tayebzaidi/HueWheel/docs/renders/counterbore.png

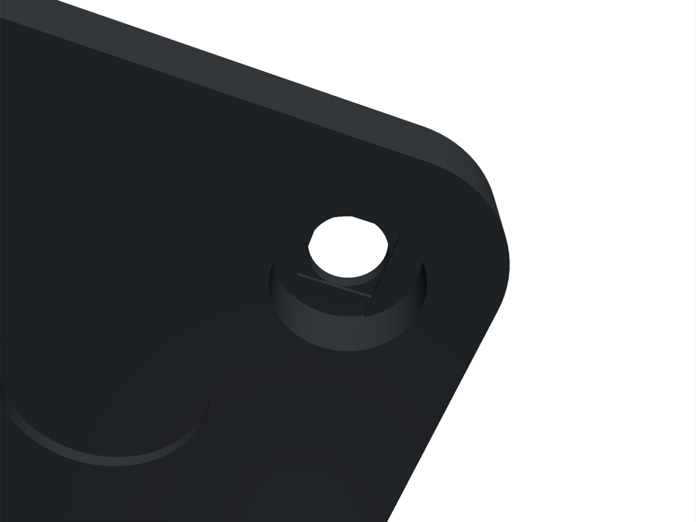
docs/renders/counterbore.png
