tayebzaidi/HueWheel/docs/renders/encoder_cradle.png

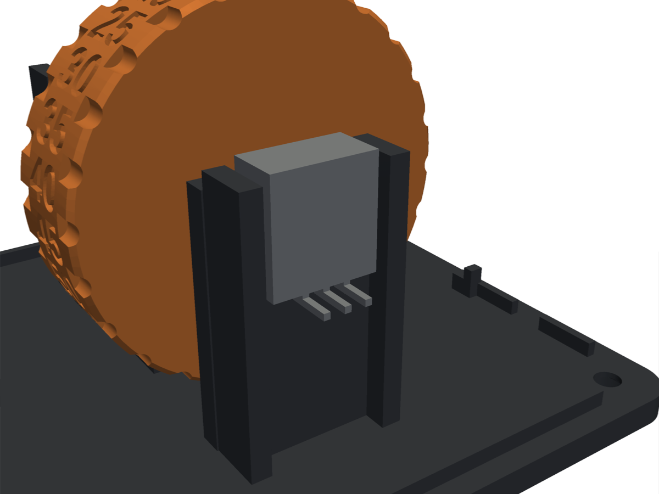
docs/renders/encoder_cradle.png
