tayebzaidi/HueWheel/docs/renders/eye_level_10deg.png

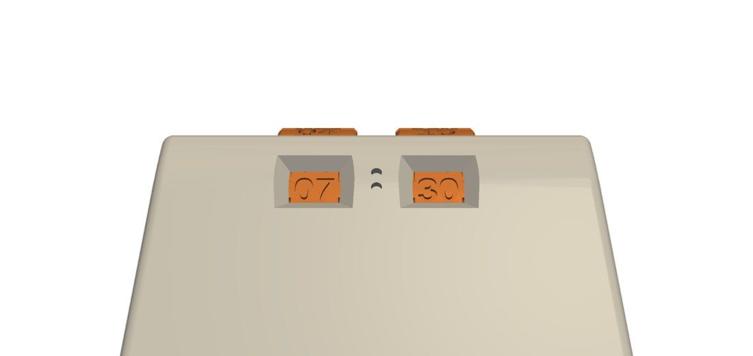
docs/renders/eye_level_10deg.png
