tayebzaidi/HueWheel/docs/renders/eye_level_25deg.png

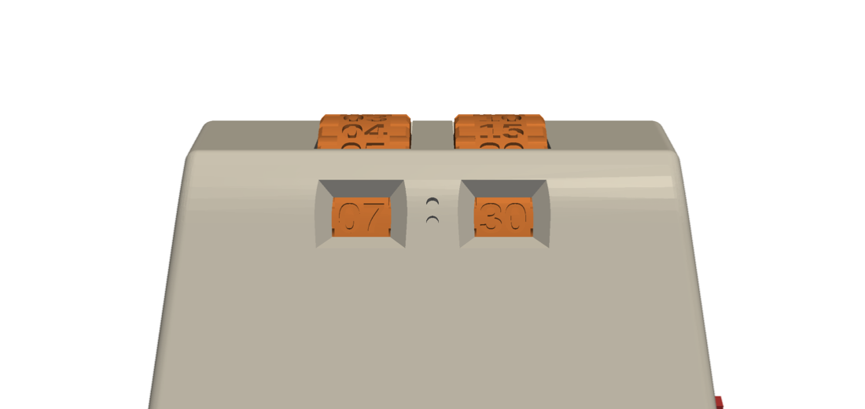
docs/renders/eye_level_25deg.png
