tayebzaidi/HueWheel/docs/renders/eye_level_46deg.png

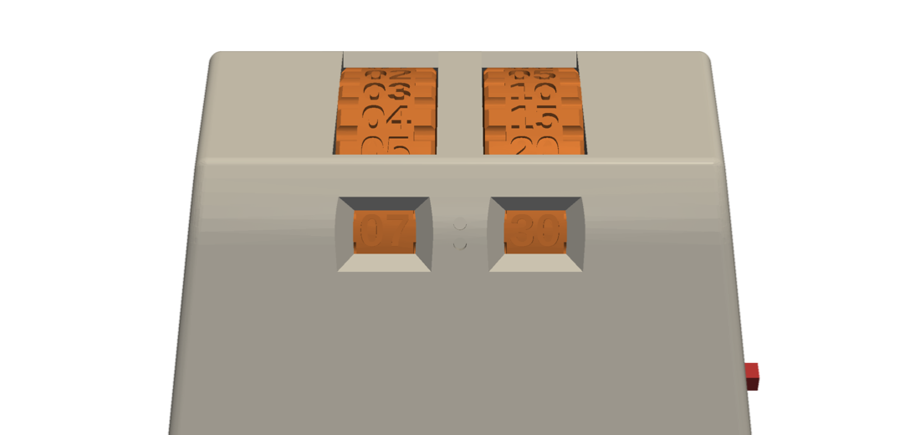
docs/renders/eye_level_46deg.png
