tayebzaidi/HueWheel/docs/renders/internals.png

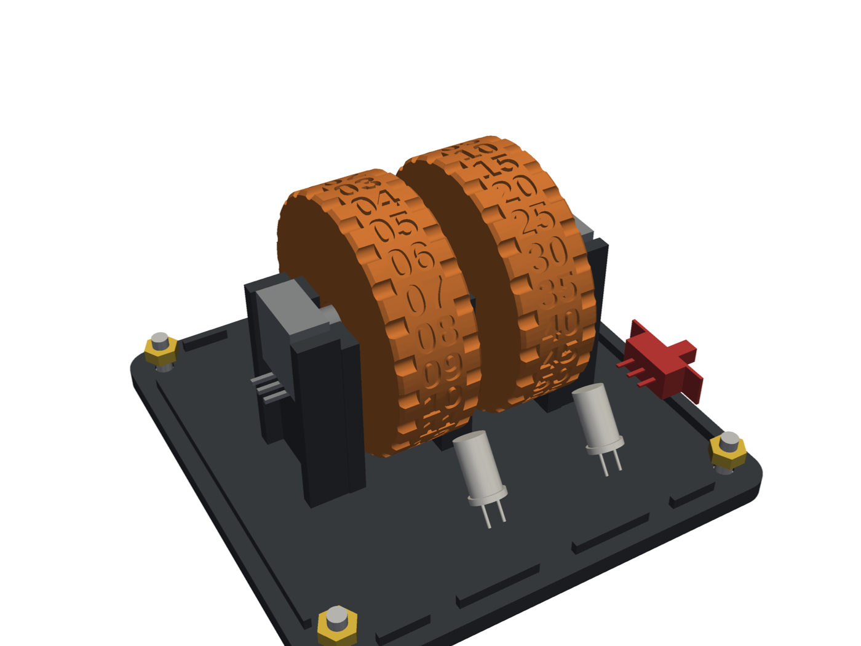
docs/renders/internals.png
