tayebzaidi/HueWheel/docs/renders/led_insert.png

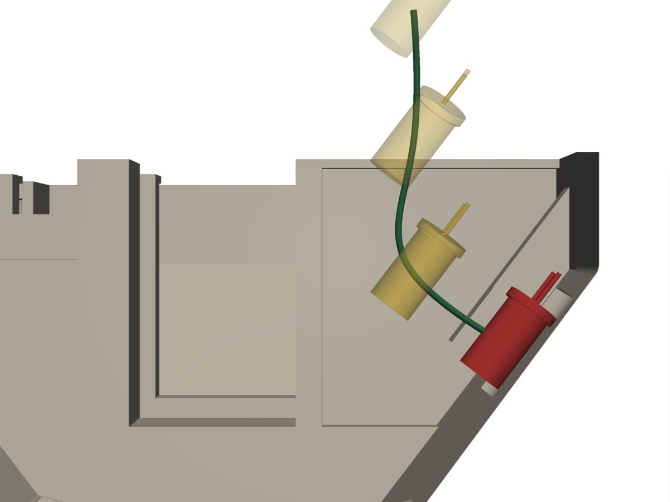
docs/renders/led_insert.png
