tayebzaidi/HueWheel/docs/renders/mcu_bay.png

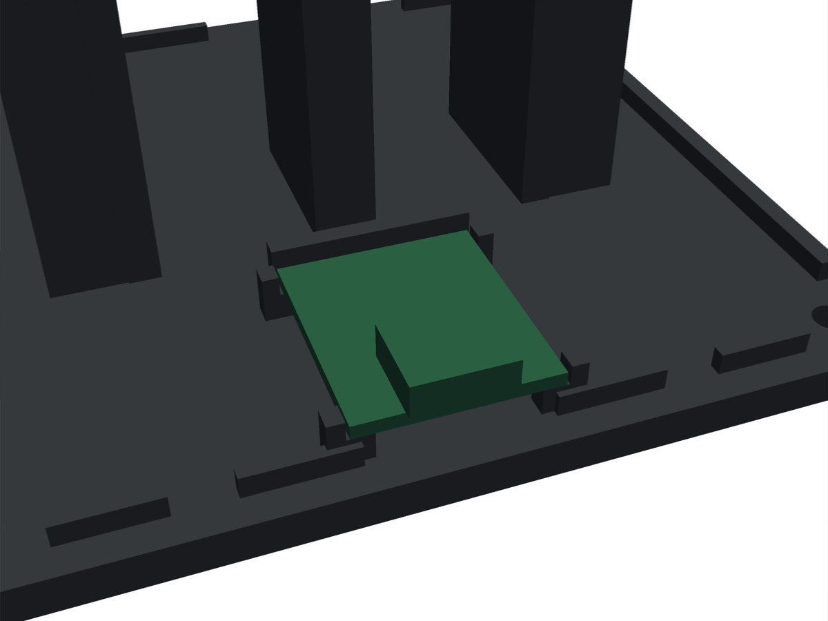
docs/renders/mcu_bay.png
