tayebzaidi/HueWheel/docs/renders/nut_slot.png

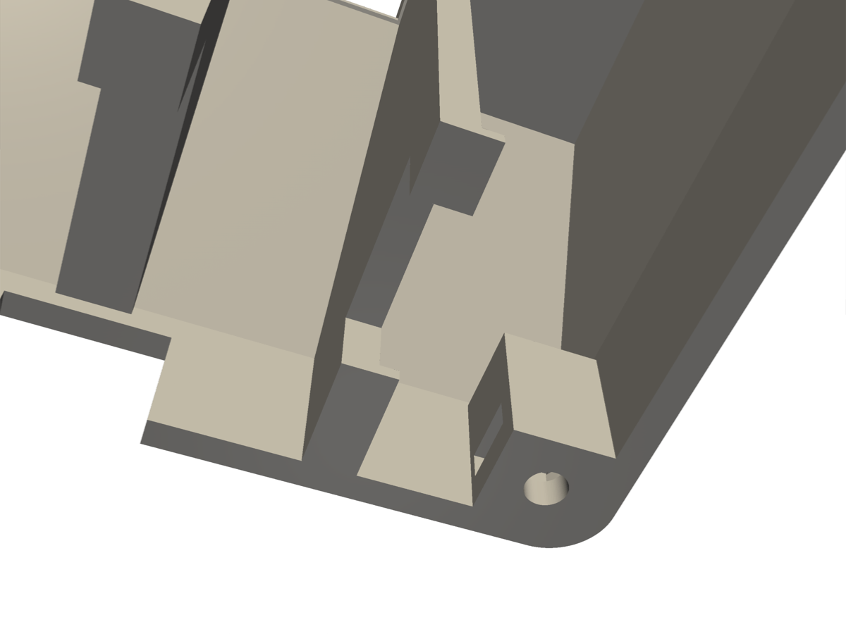
docs/renders/nut_slot.png
