tayebzaidi/HueWheel/docs/renders/plate_lip.png

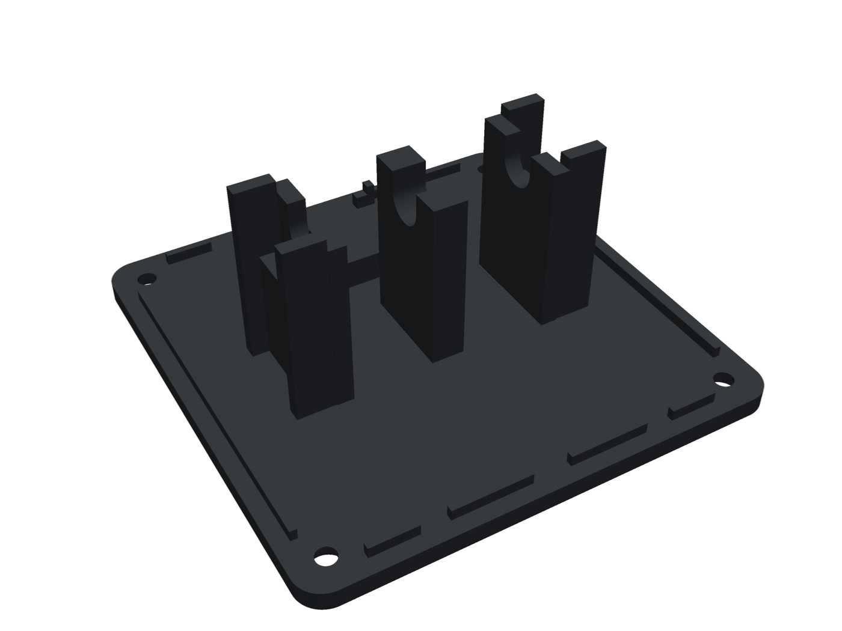
docs/renders/plate_lip.png
