tayebzaidi/HueWheel/docs/renders/section_led.png

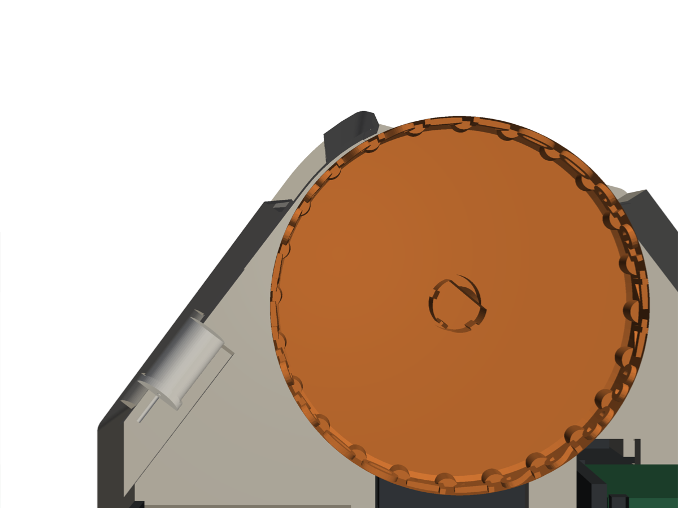
docs/renders/section_led.png
