tayebzaidi/HueWheel/docs/renders/section_nut.png

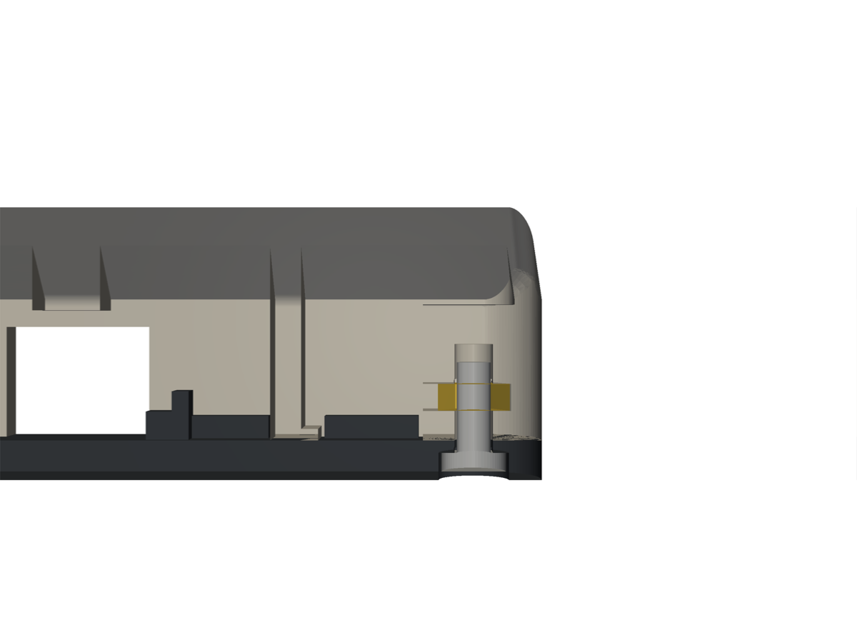
docs/renders/section_nut.png
