tayebzaidi/HueWheel/docs/renders/section_switch.png

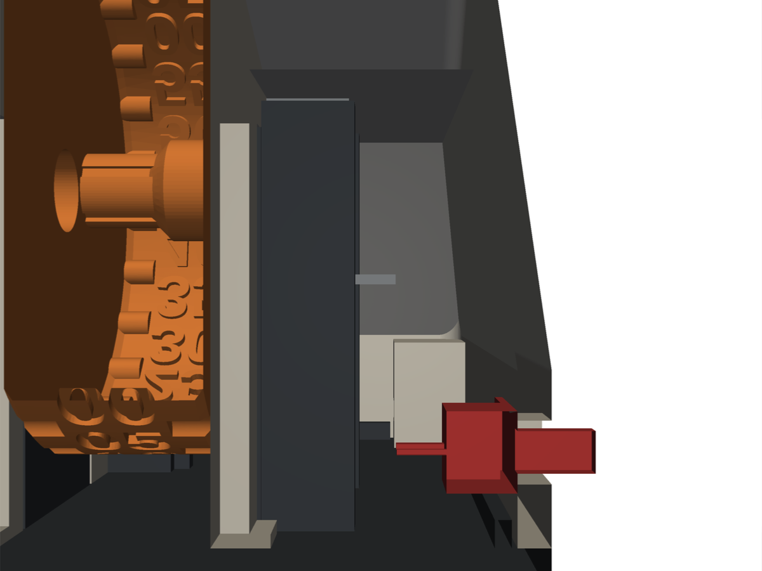
docs/renders/section_switch.png
