tayebzaidi/HueWheel/docs/renders/section_x0_usb.png

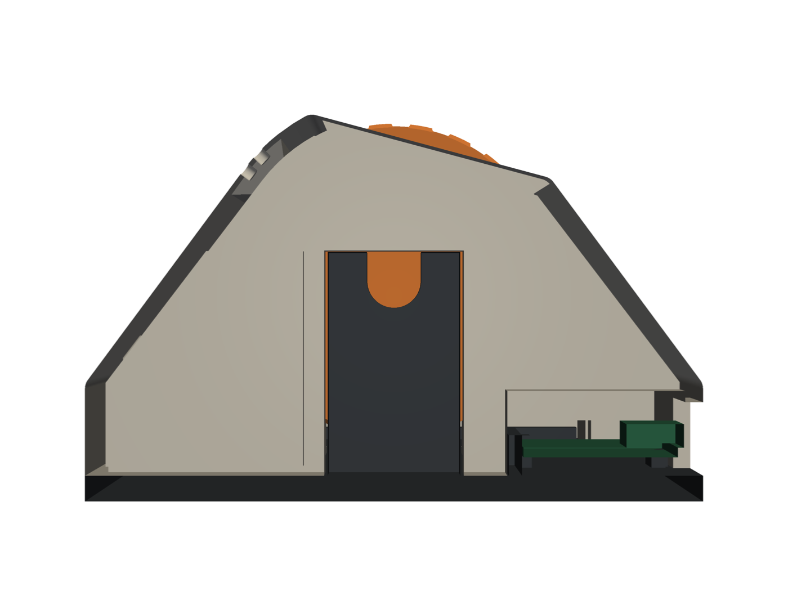
docs/renders/section_x0_usb.png
