tayebzaidi/HueWheel/docs/renders/section_x19_caps.png

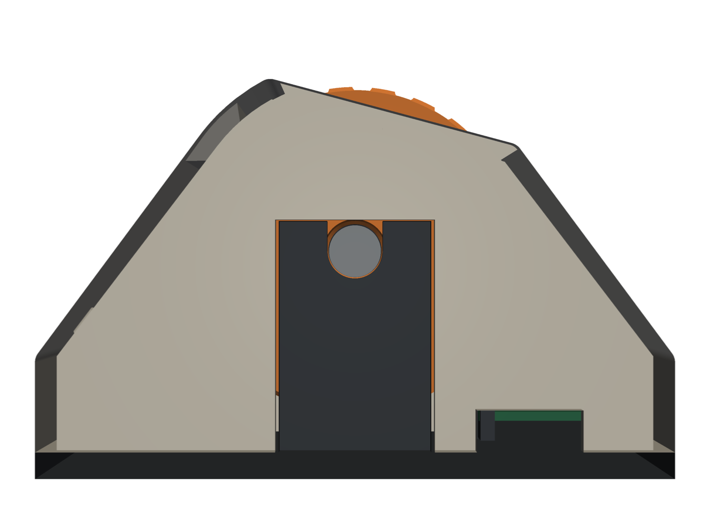
docs/renders/section_x19_caps.png
