tayebzaidi/HueWheel/docs/renders/section_x24_encoder_cap.png

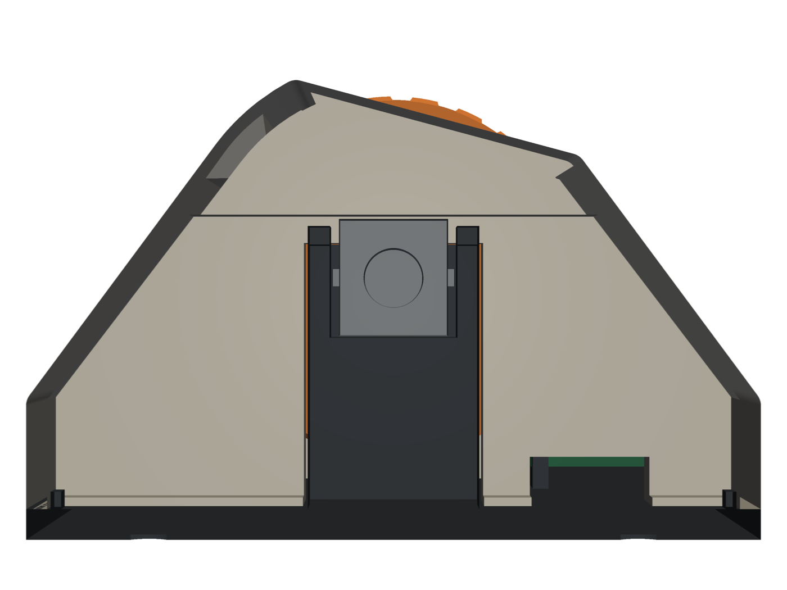
docs/renders/section_x24_encoder_cap.png
