tayebzaidi/HueWheel/docs/renders/section_y0.png

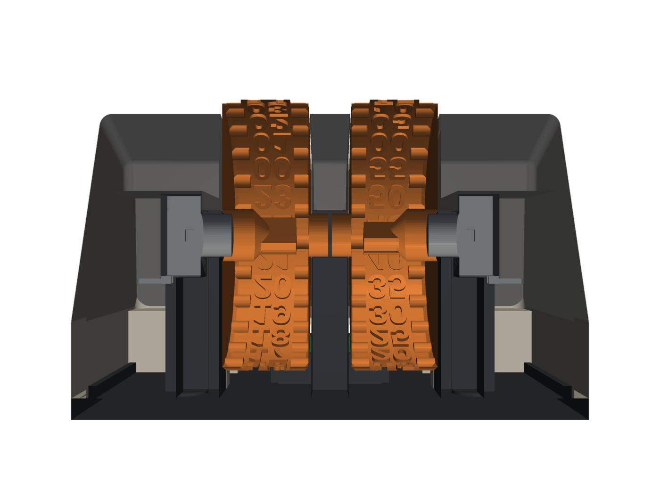
docs/renders/section_y0.png
