tayebzaidi/HueWheel/docs/renders/shell_inside.png

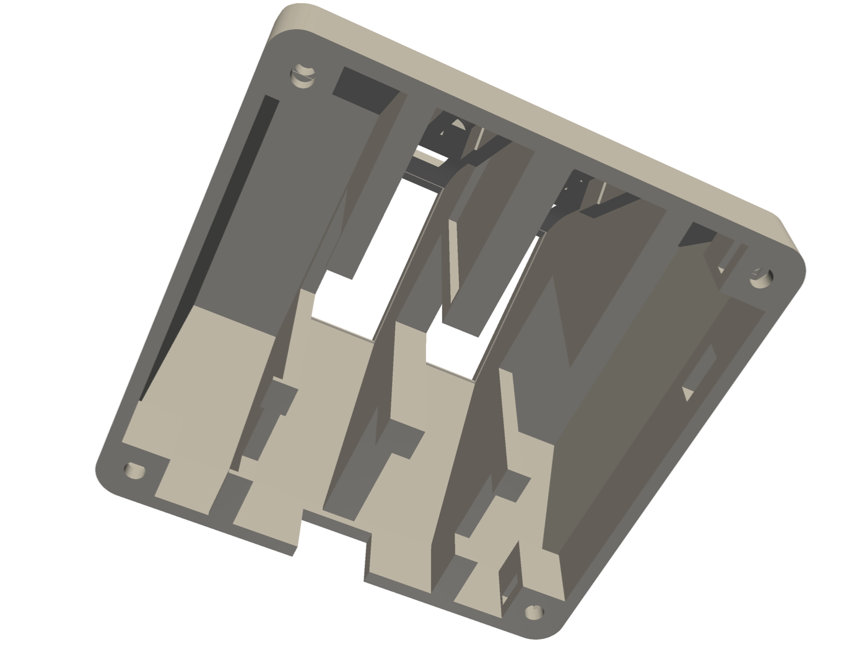
docs/renders/shell_inside.png
