tayebzaidi/HueWheel/docs/renders/underside.png

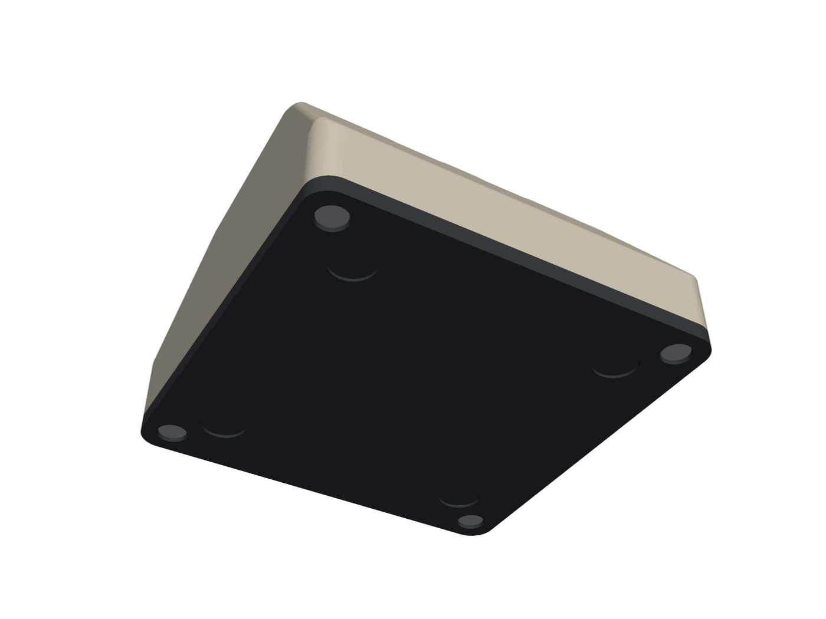
docs/renders/underside.png
