tayebzaidi/HueWheel/docs/renders/window_closeup.png

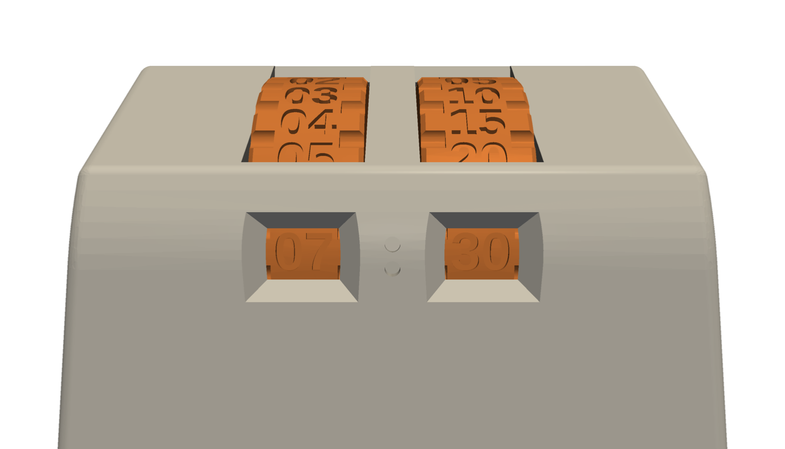
docs/renders/window_closeup.png
