tayebzaidi/HueWheel/bom/HueWheel_BOM.xlsx

Sheet: BOM
HueWheel Bill of Materials
How to use: edit the yellow cells only. Have? = Y if you already own it. Include? = N to leave an item out. Unit prices are planning estimates, not quotes; update them when you order.
Item | Specification | Qty | Unit price ($) | Have? | Include? | Line cost if buying everything ($) | Still to buy ($) | Price basis | Notes
Philips Hue Bridge | Your existing bridge | 1 | $0.00 | Y | Y |  |  | Already owned | Must be reachable from 2.4 GHz Wi-Fi. EXAMPLE ROW: shows a filled-in Have?.
Rotary encoder, 24-detent | Bourns PEC11R-4215F-N0024: 24 detents, 24 pulses, 15 mm flatted shaft, rear-facing pins, no push switch. PEC11R-4215F-S0024 (with push switch) also fits. | 2 | $2.95 |  | Y |  |  | S0024 at DigiKey, from a mymectronic aggregator snapshot; N0024 price not checked. Confirm at checkout | Do NOT substitute a different detent count: the wheel numbering depends on 24. Dimensions checked against the Bourns datasheet (rev 04/26).
Seeed XIAO ESP32C3 | DigiKey 113991054: Wi-Fi microcontroller, 21 x 17.8 mm, USB-C, antenna included | 1 | $5.00 |  | Y |  |  | Estimate from regional DigiKey listings (EUR 4.27 ex VAT, JPY 794). Check stock and lead time for the US | Chosen so everything comes from one vendor. Not the version with pre-soldered headers (102010633). The owned Pis are too big, and the micro:bits and Artemis have no Wi-Fi.
Slide switch (alarm on/off) | E-Switch EG1201A (DigiKey EG1902-ND): SPDT, panel mount, 5.5 mm actuator, 3 mm travel | 1 | $0.80 |  | Y |  |  | Estimate. Regional DigiKey EUR 0.72 at qty 1; TME USD 0.78. Confirm at checkout | Fits the existing 9 x 4.5 mm side slot and clears the 2.4 mm wall. Avoid the EG1201 and EG1218: their actuators are too short. Hot-glued from inside.
Shipping | Single DigiKey order | 1 | $7.00 |  | Y |  |  | Estimate, not checked. Confirm at checkout | Set Have? to Y if your order ships free.
5 V 1 A USB-A wall adapter | Phihong PSAA05A-050QL6-R (DigiKey 993-1394-ND): 5 V, 1 A, US plug | 1 | $4.00 |  | N |  |  | Estimate from DigiKey Australia AUD 6.14 at qty 1; US price not checked. Confirm at checkout | On hold, left out of the total. Any USB-A phone charger works.
USB-A to USB-C cable | Edatec ED-CAB-USBC: USB 2.0, 1 m. StarTech USB2AC1M is an alternative | 1 | $2.00 |  | N |  |  | DigiKey US listing, USD 2.00 at qty 1 (search snapshot). Confirm stock at checkout | On hold, left out of the total. A-to-C avoids any question of USB-C charger negotiation. Must carry data as well as power, so it can also flash the firmware.
Hookup wire | 26-30 AWG, about 1 m total | 1 | $2.00 | Y | Y |  |  | Already owned
M3 x 8 button head screws + M3 nuts (4 of each) | From the Mywish 1290-piece M2-M5 304 stainless button head kit. Nuts slide into slots in the shell's corner blocks | 1 | $17.99 | Y | Y |  |  | Amazon listing price, received | Whole kit cost shown; counted as shop stock, so not in Still to buy. Use the 8 mm screws: 12 mm and longer bottom out before the head seats.
PLA filament | About 120 g total, see Printed Parts tab | 120 | $0.02 | Y | Y |  |  | Already owned | Bambu X1 Carbon. Colours to be decided later.
Hot glue | Slide switch mount, and four dots as feet | 1 | $0.00 | Y | Y |  |  | Already owned | Replaces rubber feet.
Ballast | Steel washers, nuts or coins glued inside the front of the base | 1 | $0.00 |  | N |  |  | Scrap | Only if it slides when you roll a wheel.
Numeral contrast | Fine marker or paint pen in the engraved numerals | 1 | $0.00 | Y | Y |  |  | Already owned | Use black or another dark colour: a red numeral disappears under a red LED.
LEDs (window light) | 5 mm through-hole, diffused if available; red or amber recommended. 3 mm also works: set LED_D and LED_LEN in cad/huewheel.py | 2 | $0.05 | Y | Y |  |  | Already owned | One per window, in holders inside the front slope.
Resistors for the LEDs | 220-470 ohm, 1/4 W through-hole, one per LED, from your kit | 2 | $0.02 | Y | Y |  |  | Already owned | Solder in line with each LED, then cover with tape or heat shrink.
 | If you bought every included item
 | Still to buy
 | Budget |  |  |  |  |  | $30.00
 | Left in budget

Sheet: Printed Parts
Printed Parts
Weight and time: PrusaSlicer 2.9.6 default 0.4 mm profile, 0.2 mm layers, 15% infill, PLA at 1.24 g/cm3. Your printer's times will differ.
Part | STL | Qty | Weight (g) | Time (h) | Supports | Print orientation
Base plate | cad/stl/plate.stl | 1 | 27.9 | 2.97 | None | Flat as exported; cradles point up
Shell | cad/stl/shell.stl | 1 | 71.5 | 5.42 | Build plate only (figures include them) | Open side down on the bed, as exported
Hours wheel | cad/stl/wheel_hours.stl | 1 | 9.3 | 0.82 | None | On its side, stub boss up, as exported
Minutes wheel | cad/stl/wheel_minutes.stl | 1 | 9.4 | 0.83 | None | On its side, stub boss up, as exported
Total
