tayebzaidi/HueWheel/cad/stl/wheel_minutes.stl

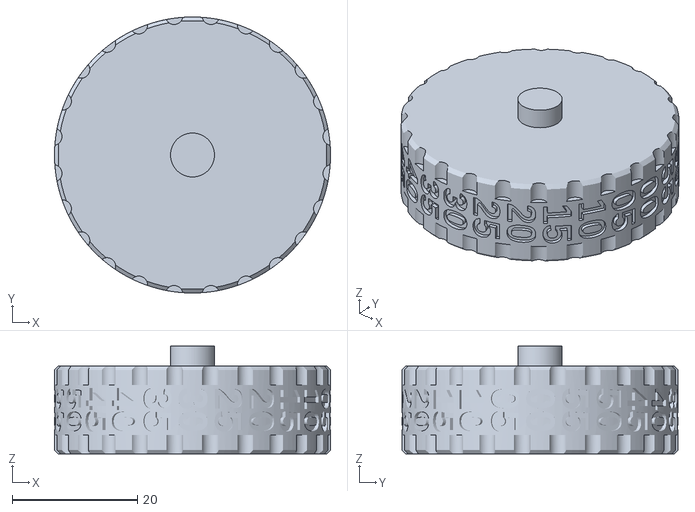
[picture p24: CAD file, 2026-11-09]
cad/stl/wheel_minutes.stl
44.0 x 44.0 x 17.2
