tayebzaidi/HueWheel/cad/test/rib_test.stl

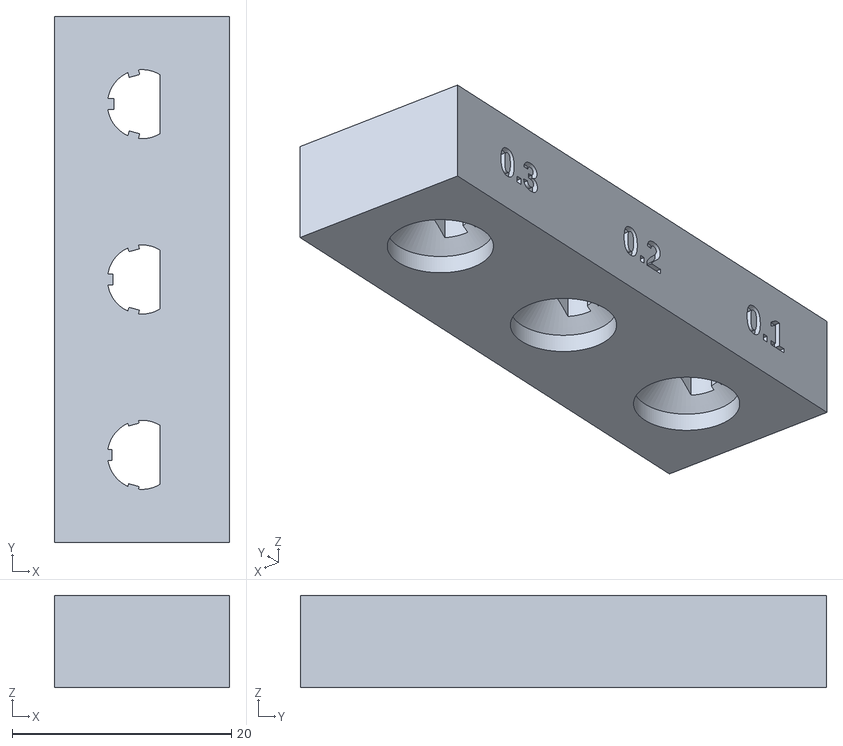
[picture p25: CAD file, 2026-11-09]
cad/test/rib_test.stl
16.0 x 48.0 x 8.40
