tayebzaidi/HueWheel/cad/stl/shell.stl

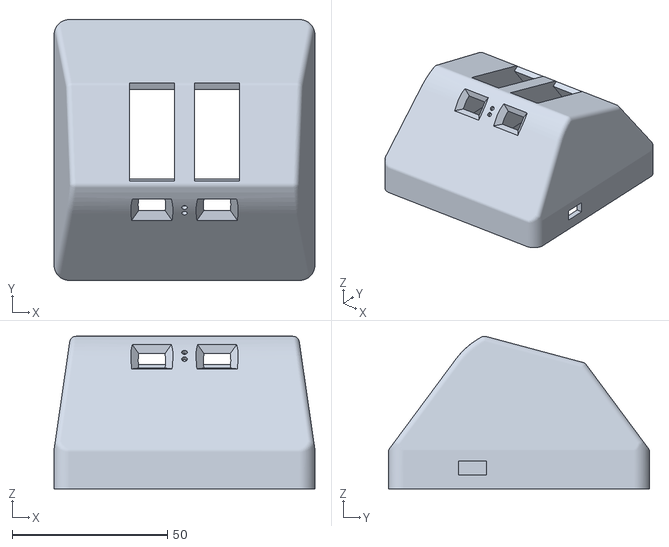
[picture p26: CAD file, 2026-11-06]
cad/stl/shell.stl
84.0 x 84.0 x 49.1
