tayebzaidi/HueWheel/cad/test/clamp_test.stl

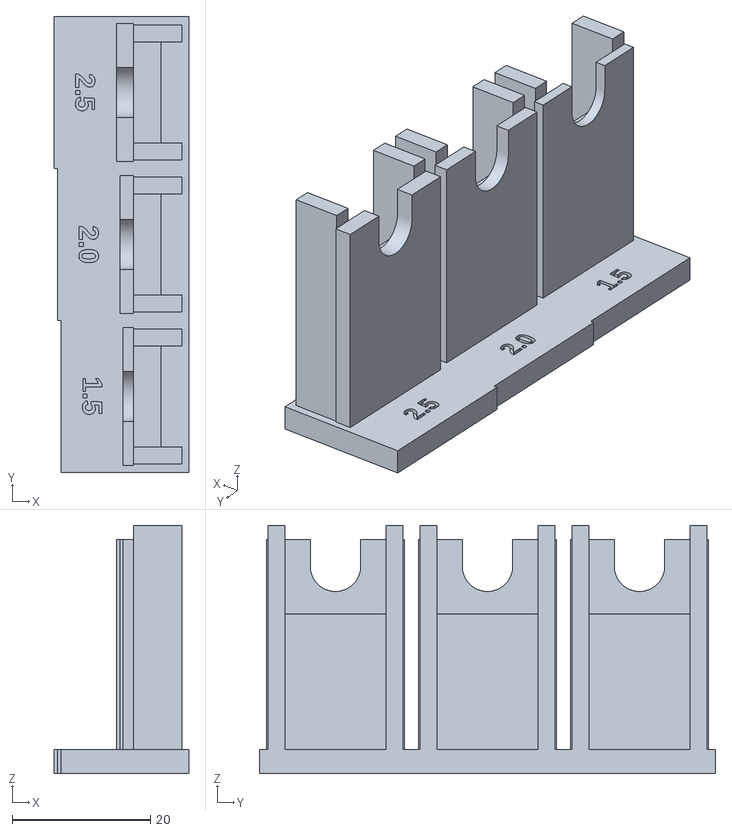
[picture p27: CAD file, 2026-11-09]
cad/test/clamp_test.stl
19.5 x 66.0 x 35.9
