tayebzaidi/HueWheel/cad/stl/plate.stl

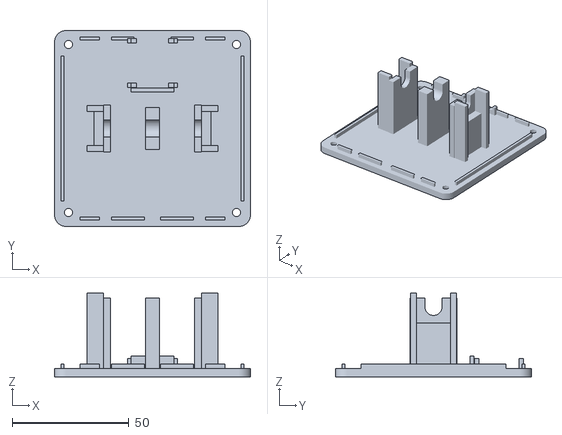
[picture p28: CAD file, 2026-11-04]
cad/stl/plate.stl
84.0 x 84.0 x 35.9
