tayebzaidi/HueWheel/cad/test/nut_test.stl

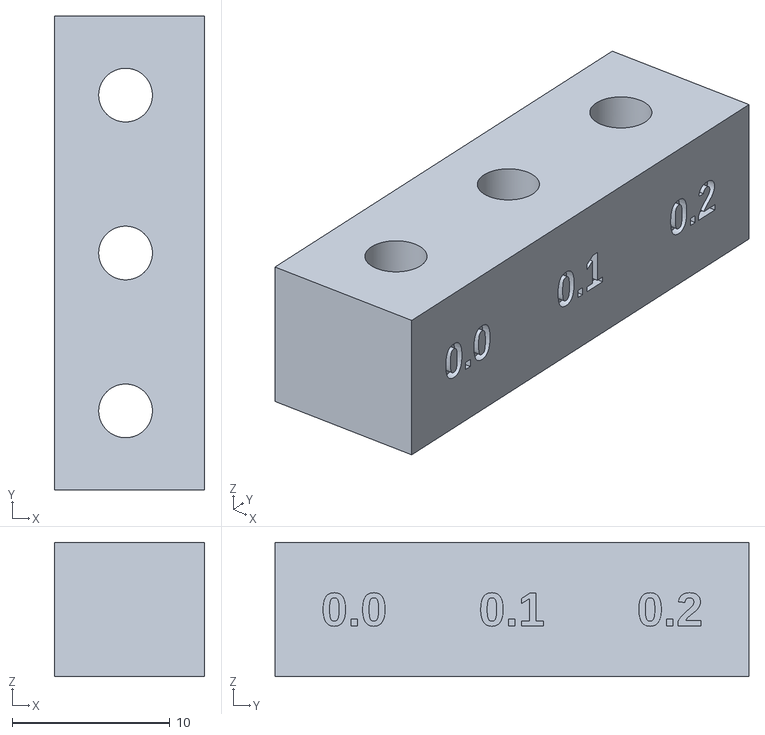
[picture p29: CAD file, 2026-11-09]
cad/test/nut_test.stl
9.50 x 30.0 x 8.50
