tayebzaidi/HueWheel/(list of files, cad)

Other CAD files:
cad/stl/wheel_hours.stl
