tayebzaidi/HueWheel/(commit log)

2026-11-02 Add first-pass HueWheel enclosure CAD, BOM and README
    [HueWheel_BOM.xlsx, plate.stl, shell.stl, wheel_hours.stl, wheel_minutes.stl]
2026-11-02 Match encoder geometry to Bourns datasheet and update BOM for owned hardware
    Correct the shaft flat, bushing, body and pin clearances, move the board
    mount to the XIAO ESP32C3, and consolidate purchases into one vendor.
    [HueWheel_BOM.xlsx, plate.stl, shell.stl, wheel_hours.stl, wheel_minutes.stl]
2026-11-02 Specify the E-Switch EG1201A alarm switch in the BOM
    [HueWheel_BOM.xlsx]
2026-11-02 Specify DigiKey M3 screws and deepen plate counterbores
    [HueWheel_BOM.xlsx, plate.stl]
2026-11-02 Record the ordered M3 screw kit in the BOM
    [HueWheel_BOM.xlsx]
2026-11-02 Specify DigiKey USB adapter and cable in the BOM
    [HueWheel_BOM.xlsx]
2026-11-02 Put USB adapter and cable on hold in the BOM
    [HueWheel_BOM.xlsx]
2026-11-02 Fit the model to the final parts and add assembly checks
    Replace the board rails with corner seats that leave the soldered edges
    clear, model the slide switch and M3 button head screws, enlarge the
    USB cable notch, and test the assembly paths and switch travel.
    [HueWheel_BOM.xlsx, plate.stl, shell.stl]
2026-11-02 Replace plastic screw threads with captive M3 nuts
    Add a side-loading nut slot to each shell corner block, clear the screw
    bores, and check nut insertion and screw engagement.
    [HueWheel_BOM.xlsx, shell.stl]
2026-11-02 Improve numeral visibility and add LED window lighting
    Flare the windows, enlarge the digits, lower the window for shallow
    viewing angles, and add two LED holders using parts already on hand.
    [HueWheel_BOM.xlsx, shell.stl, wheel_hours.stl, wheel_minutes.stl]
2026-11-02 Add first-draft firmware and Hue dry-run tool
    Firmware for the XIAO ESP32C3: reads both encoders and the alarm switch,
    saves the wheel position, and sends the time to a Wake Up automation once
    the wheels go quiet. Includes a re-sync gesture and a pin map.
    tools/hue_dryrun.py makes the same edit from a PC. Tested that way against a
    real bridge; the firmware itself has not run on hardware yet.
2026-11-03 Make all parts print without supports; add 3D viewer
    The first shell print failed where it hung over air: the tilted roof
    over the encoders, the retaining ribs and the LED holders. The plate's
    counterbores failed too.
    - Shell: the encoder roof and retaining ribs become solid blocks with
    flat undersides that bridge wall to wall. Pillars from the bed keep
    each bridge to 21 mm or less. The plate's U-cradles are 3 mm lower so
    the shell caps them.
    - LED holders sit on two fins from the bed, joined by a short bridge.
    - Screw holes in the plate and nut slots: two bridged layers (a slot,
    then a square) before the round hole.
    - Wheels: 45 degree cone at the bottom of the shaft pocket.
    - cad/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
    [plate.stl, shell.stl, wheel_hours.stl, wheel_minutes.stl]
2026-11-03 Document the single conda environment for the CAD tools
    All CAD scripts, the print check, renders and viewer now run in one
    conda environment. The README explains how to make Anaconda's VTK open
    windows on Linux: use the system Mesa, and preload the system's newer
    libstdc++ and libdrm. printcheck.py also needs rtree.
2026-11-03 Shell: replace free-standing pillars with walls tied to the outer shell
    The second shell print failed: the six 31 mm support pillars under the
    retainer caps stood alone on 3 mm footprints and fell over. Each retainer
    is now a wall from the bed out to the front and rear walls, with a window
    over its cradle. The centre rear wall arches over the board and USB-C
    port, and the rear encoder walls have a doorway for the encoder and
    switch wires. LED fins go from 1.2 to 1.6 mm.
    printcheck.py now also fails narrow islands growing from the bed that
    stand taller than 5x their width before joining a wide part; it flags
    exactly the six pillars that fell. README gains full print settings.
    Co-Authored-By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
    [shell.stl]
2026-11-03 Shell: thicken thin inner walls and give them bed feet
    On the third shell print a 1.6 mm LED fin curled up off the bed on the
    first layer. The fins go from 1.6 to 2.4 mm, growing outward so the lead
    gap is unchanged, and the front centre rib from 2.0 to 3.0 mm. The first
    1 mm of each thin wall is now 1.5 mm wider per side: each fin pair stands
    on one pad, and the encoder walls flare outward only so the shell still
    drops on past the wheels. Fit check and print check pass.
    printcheck.py now fails first-layer strips narrower than 2.4 mm (the outer
    wall); it flags exactly the old fins and rib.
    [shell.stl]
2026-11-04 Heat-set inserts, plate lip and open LED slots
    - Shell corner blocks take M3 x 6 x 4.2 heat-set inserts instead of captive
    nuts, which were hard to place and too tight. Each hole opens on the shell
    underside with a lead-in chamfer and a 45 degree cone roof.
    - New insert test block in cad/test/ to pick the hole size (3.8-4.2 mm)
    before printing the shell.
    - Plate gets a low lip just inside the shell wall to seat the shell before
    the screws go in. It steps around every shell wall and foot at the edge.
    - LEDs default to 5 mm and sit 8 mm lower on the front slope, clear of the
    wheels. The closed tube holder could not be fitted with an LED, so each is
    now an open slot between two wall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
    [HueWheel_BOM.xlsx, insert_test.stl, plate.stl, shell.stl]
2026-11-06 Back to captive nuts, with a 2.4 mm slot
    - Shell corner blocks take M3 nuts again instead of heat-set inserts. With
    real nuts the slots were easy to load, but the 2.6 mm slot was loose, so
    the slot is now 2.4 mm tall: one 0.2 mm layer less, with the floor and roof
    still on layer lines.
    - Remove the insert test block. README, BOM, assemble.py checks and renders
    go back to nuts. The plate lip and open LED slots stay.
    [HueWheel_BOM.xlsx, insert_test.stl, shell.stl]
2026-11-09 Wheel crush ribs, plus rib, nut-slot and encoder-clamp test pieces
    The wheels' D bore gets three crush ribs (RIB_I, 0.2 mm placeholder) for a firm fit
    that still pulls off; one sits opposite the flat to remove turning play. assemble.py
    now models the shaft and checks that only the ribs touch it.
    Test pieces in cad/test, none part of the build:
    - rib_test: hubs with 0.1/0.2/0.3 mm ribs, to pick RIB_I
    - nut_test: shell nut bosses at 2.6 mm slot height and 0.0/0.1/0.2 mm width clearance
    - clamp_test: plate encoder sockets with 1.5/2.0/2.5 mm uprights, to size the
    nut-and-washer clamp
    [clamp_test.stl, nut_test.stl, rib_test.stl, wheel_hours.stl, wheel_minutes.stl]
